smartfriendz/smartrap/README.md

smartrap
========

the easy to build reprap
