smartfriendz/smartrap/doc/smartrap 0.4.9.2-contenu boite.pdf

barres inox | 4x6 + 2x8 - 300mm | barres inox | 4x6 + 2x8 - 300mm
m5 Z | 1x - 220mm | m5 Z | 1x - 220mm

hotend

nozzle 0.4 + barrel 26mm
+ ptfe 15x40 + pressfit+
block alu + thermistor +
| 40w cartridge | hotend | nozzle 0.4 + barrel 26mm
| | | + ptfe 15x40 + pressfit+
| | | block alu + thermistor +
| | | 40w cartridge
mk7 | 1x | mk7 | 1x
printed parts | | printed parts
motors | 4x | motors | 4x
endstops | 3x | endstops | 3x
bearings | 4x lm8uu + 8x lm6uu | bearings | 4x lm8uu + 8x lm6uu
bowden | 1x 70cm | bowden | 1x 70cm
ramps | 1 arduino + 1 ramps 1.4 +
| 4 pololus | ramps | 1 arduino + 1 ramps 1.4 +
| | | 4 pololus
gt2 | 2x 50cm belt + 2x 20
| teeth alu | gt2 | 2x 50cm belt + 2x 20 teeth
| | | alu
2pins 70cm | 2x | 2pins 70cm | 2x
power supply | 1x 6amps 12v | power supply | 1x 6amps 12v
wood | 220x220 10mm multi | wood | 220x220 10mm multi
glass | 220x220 3mm | glass | 220x220 3mm

screws

20x m3x10 , 7x m3x16 ,
3x m3x25 , 3xm3x30 , 1x
| m3x10extrud, 5x m3 nuts, | screws | 20x m3x10 , 7x m3x16 ,
| | | 3x m3x25 , 3xm3x30 , 1x
| | | m3x10extrud, 5x m3 nuts,
zcoupler metal | 1x coupler 5mm/5mm | zcoupler metal | 1x coupler 5mm/5mm
usb cable | | usb cable
power cable | | power cable
fan head | | fan head
filament | | filament
