smartfriendz/smartrap/doc/Screen Shot 2015-01-23 at 09.19.43.png

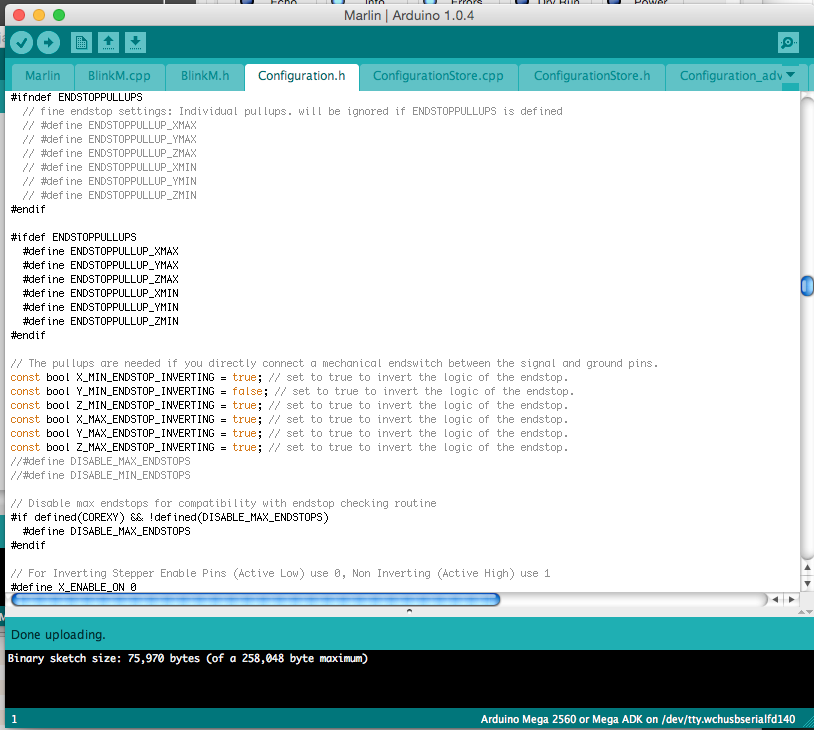
doc/Screen Shot 2015-01-23 at 09.19.43.png
