smartfriendz/smartrap/doc/Screen Shot 2015-01-23 at 09.33.37.png

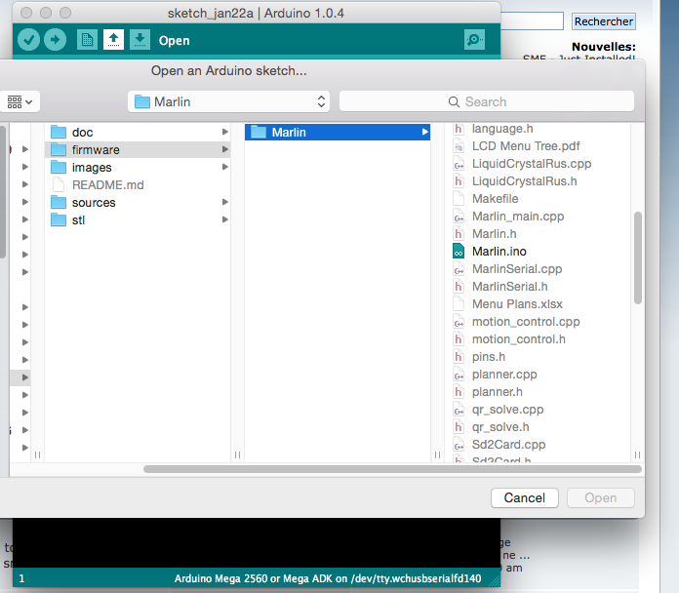
doc/Screen Shot 2015-01-23 at 09.33.37.png
