smartfriendz/smartrap/doc/Screen Shot 2015-01-23 at 09.33.49.png

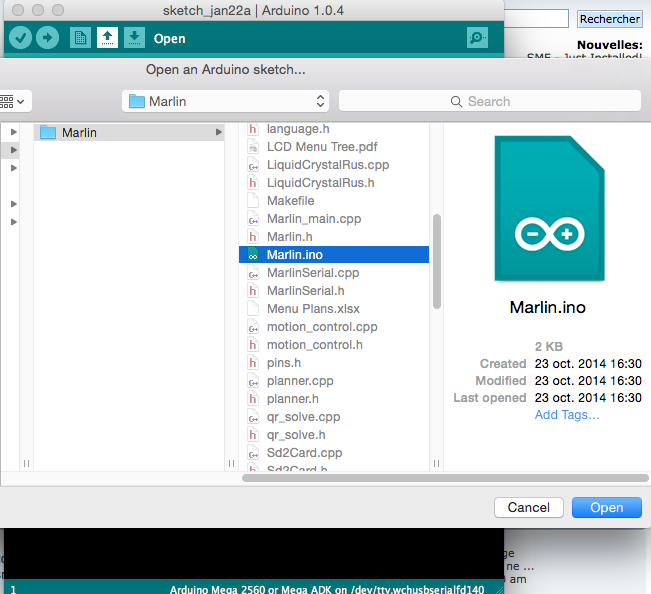
doc/Screen Shot 2015-01-23 at 09.33.49.png
