smartfriendz/smartrap/doc/Screen Shot 2015-01-23 at 09.36.03.png

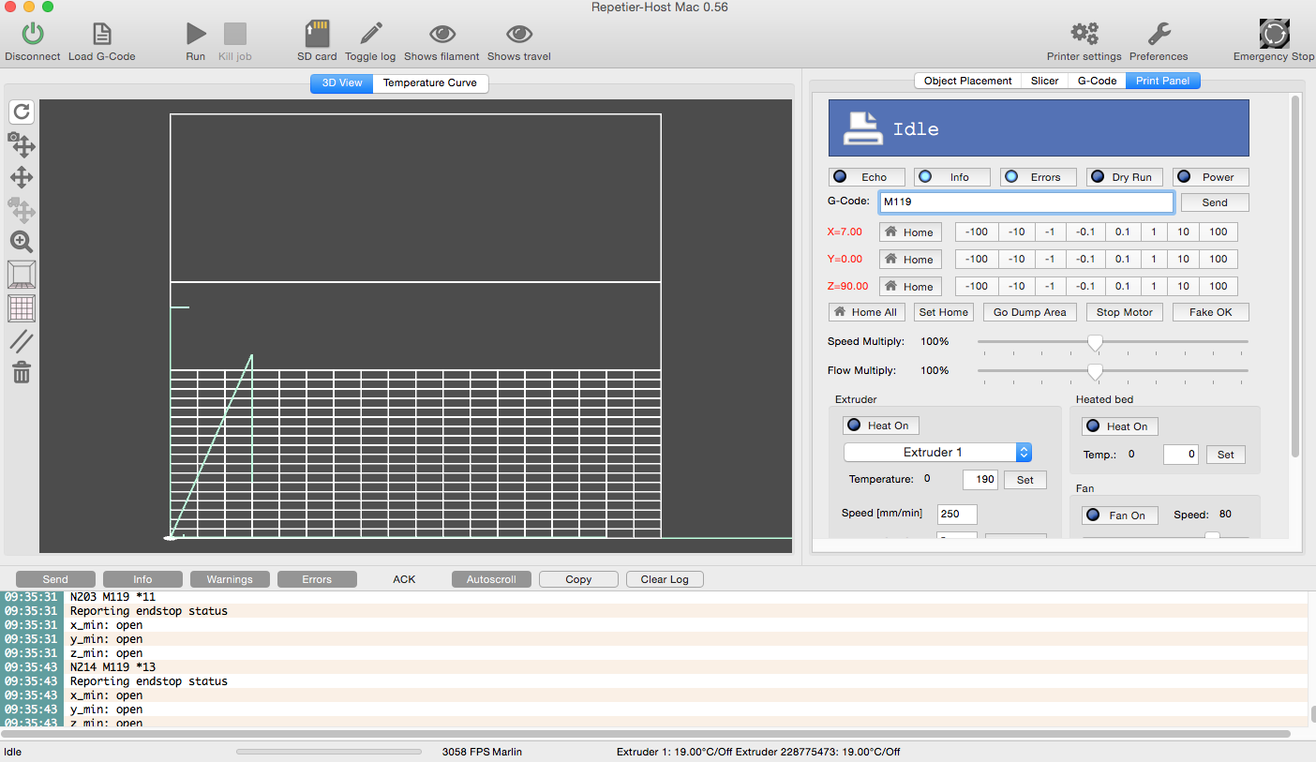
doc/Screen Shot 2015-01-23 at 09.36.03.png
