smartfriendz/smartrap/blender/smartrap_8mm_plateX.stl

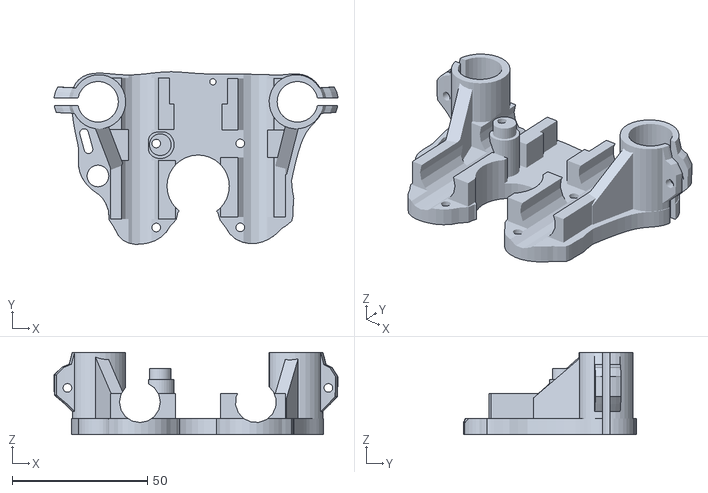
[picture p5: CAD file, 2014-12-14]
blender/smartrap_8mm_plateX.stl
104.9 x 63.7 x 30.4
