smartfriendz/smartrap/stl/separate_Items/endx_jhead_attach.stl

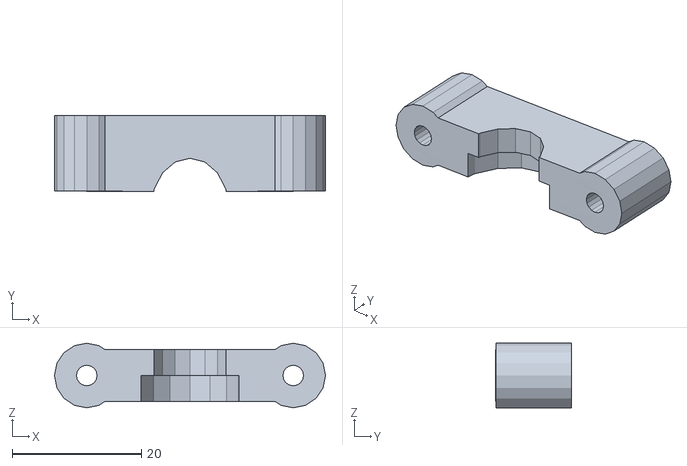
[picture p6: CAD file, 2015-07-18]
stl/separate_Items/endx_jhead_attach.stl
42.0 x 11.7 x 10.0
