smartfriendz/smartrap/stl/smartrap_plates_1on2_jhead.stl

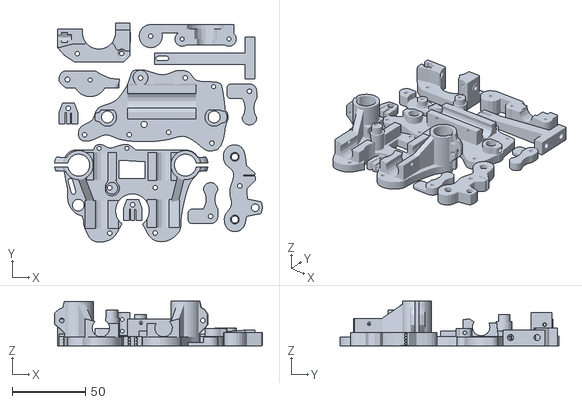
[picture p7: CAD file, 2015-07-18]
stl/smartrap_plates_1on2_jhead.stl
142.1 x 149.8 x 30.4
