smartfriendz/smartrap/stl/separate_Items/endx_jhead_arm.stl

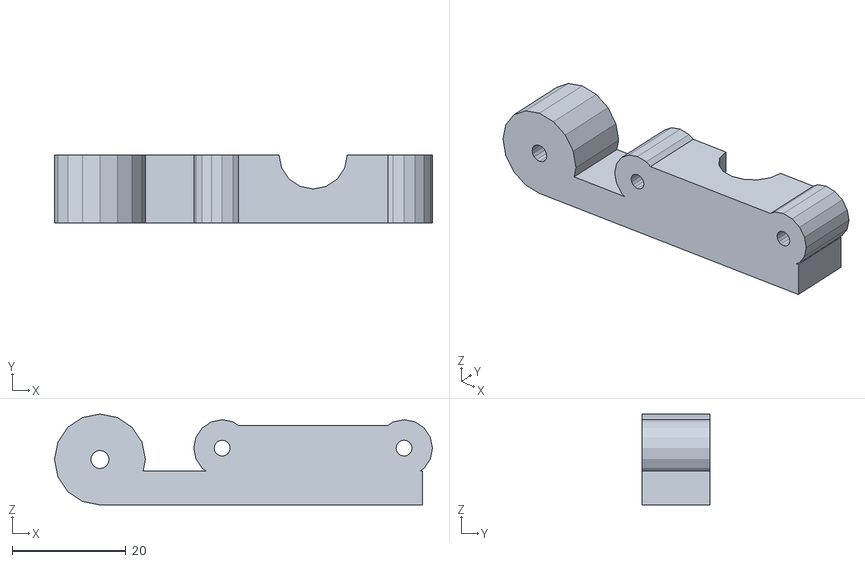
[picture p8: CAD file, 2015-07-18]
stl/separate_Items/endx_jhead_arm.stl
66.5 x 12.0 x 16.0
