smartfriendz/smartrap/stl/smartrap_plates_8mm_gt2_1.stl

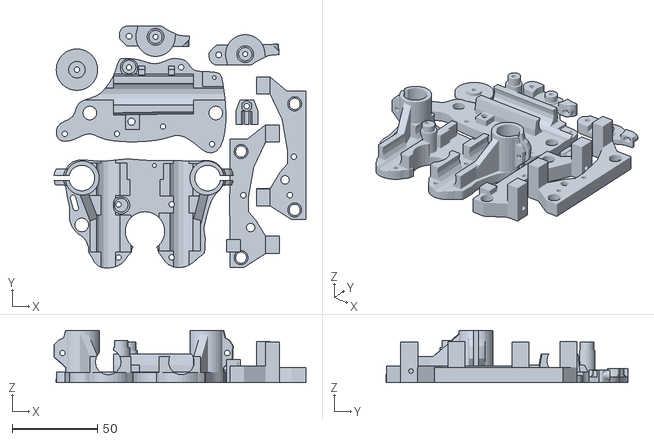
[picture p9: CAD file, 2015-07-18]
stl/smartrap_plates_8mm_gt2_1.stl
147.4 x 141.6 x 30.4
