smartfriendz/smartrap/stl/separate_Items/endx_jhead.stl

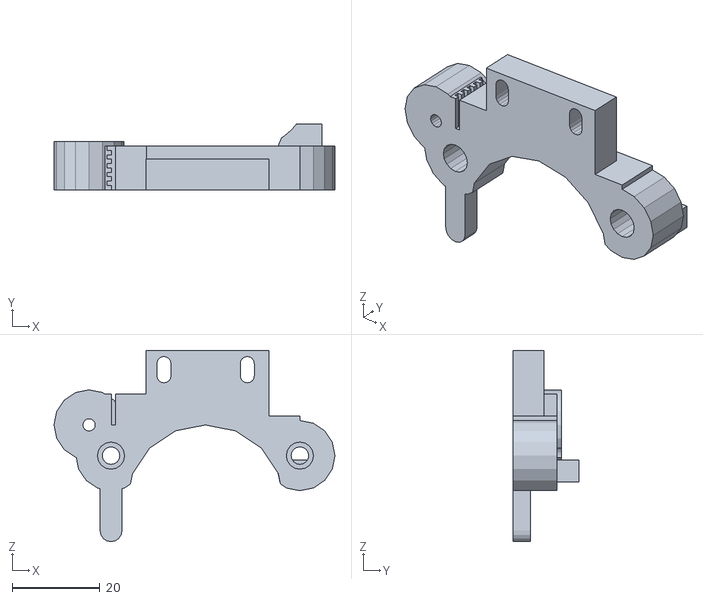
[picture p10: CAD file, 2015-07-18]
stl/separate_Items/endx_jhead.stl
64.1 x 15.0 x 43.6
