smartfriendz/smartrap/stl/smartrap_plates_2on2_jhead.stl

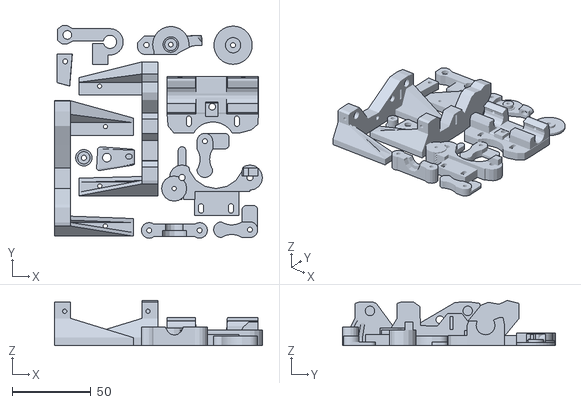
[picture p11: CAD file, 2015-07-18]
stl/smartrap_plates_2on2_jhead.stl
132.0 x 134.9 x 28.6
