smartfriendz/smartrap/stl/separate_Items/endx_jhead_inductive.stl

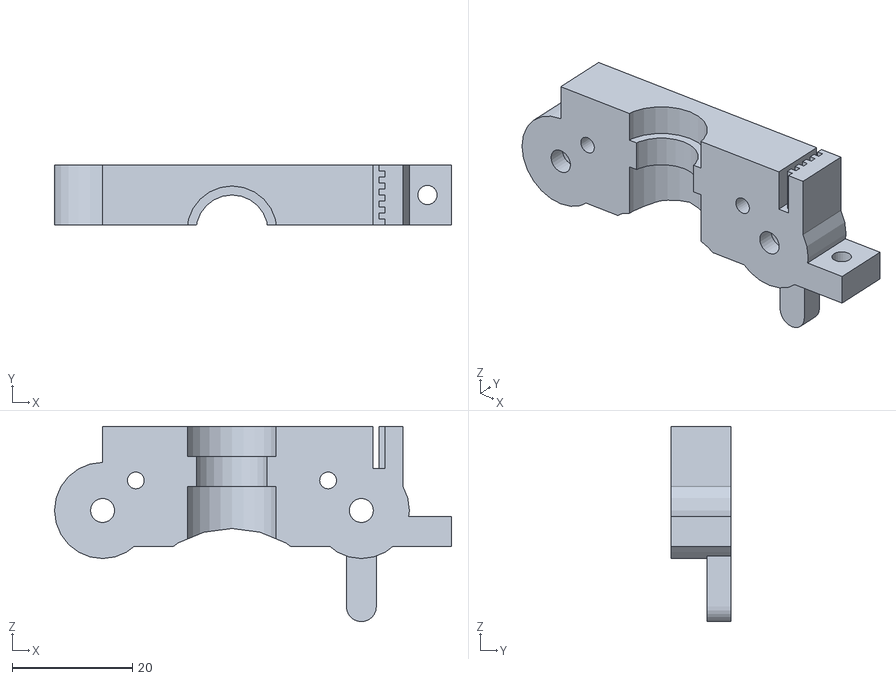
[picture p12: CAD file, 2015-02-06]
stl/separate_Items/endx_jhead_inductive.stl
66.1 x 10.0 x 32.5
