smartfriendz/smartrap/stl/smartrap_plates_8mm_gt2_2.stl

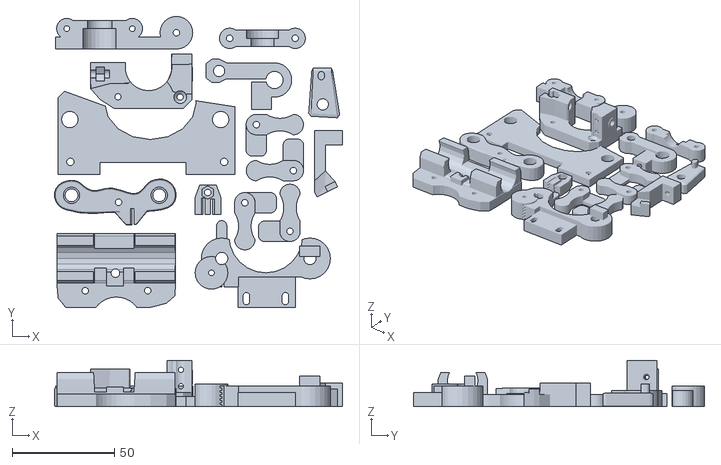
[picture p13: CAD file, 2015-07-18]
stl/smartrap_plates_8mm_gt2_2.stl
140.6 x 142.2 x 22.6
