smartfriendz/smartrap/stl/separate_Items/endx_jhead_inductive_support.stl

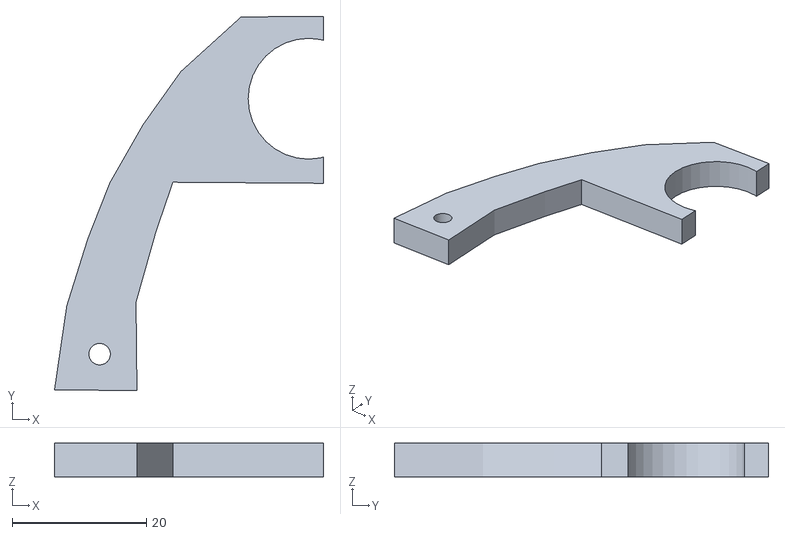
[picture p14: CAD file, 2015-02-06]
stl/separate_Items/endx_jhead_inductive_support.stl
40.1 x 55.8 x 5.02
