smartfriendz/smartrap/stl/separate_Items/endx_jheadlite_inductivesensor_attach.stl

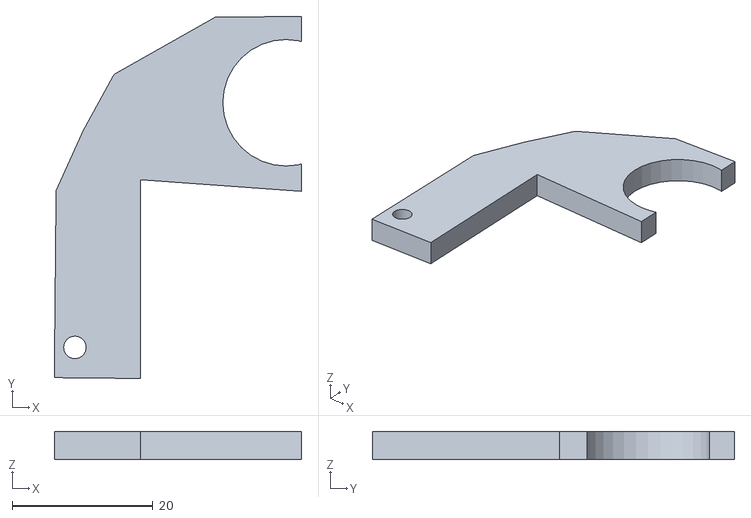
[picture p15: CAD file, 2015-02-06]
stl/separate_Items/endx_jheadlite_inductivesensor_attach.stl
35.2 x 51.5 x 4.00
