smartfriendz/smartrap/stl/separate_Items/directdrive_body_m4.stl

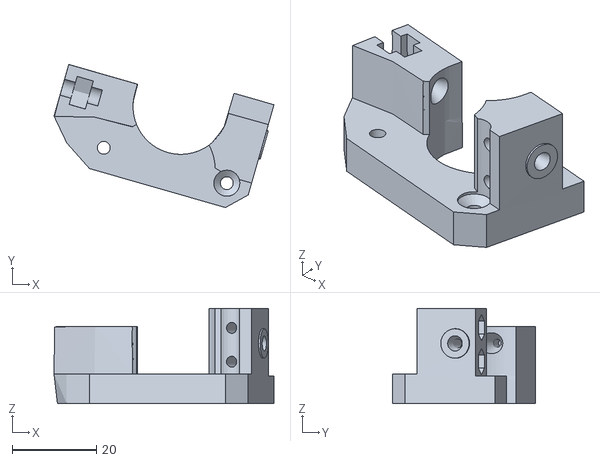
[picture p16: CAD file, 2014-12-14]
stl/separate_Items/directdrive_body_m4.stl
52.2 x 34.0 x 22.6
