smartfriendz/smartrap/stl/separate_Items/directdrive_iddle_10mm_top.stl

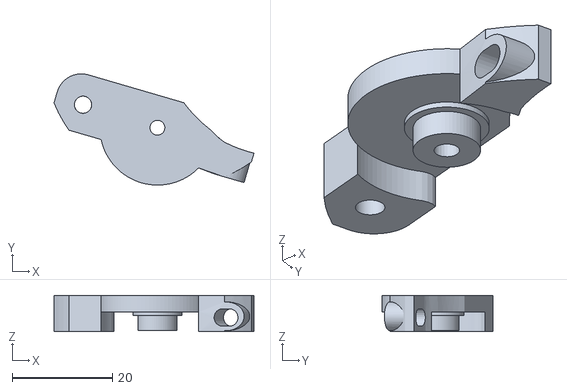
[picture p17: CAD file, 2014-12-14]
stl/separate_Items/directdrive_iddle_10mm_top.stl
39.8 x 22.1 x 7.21
