smartfriendz/smartrap/stl/separate_Items/directdrive_iddle_10mm_bottom.stl

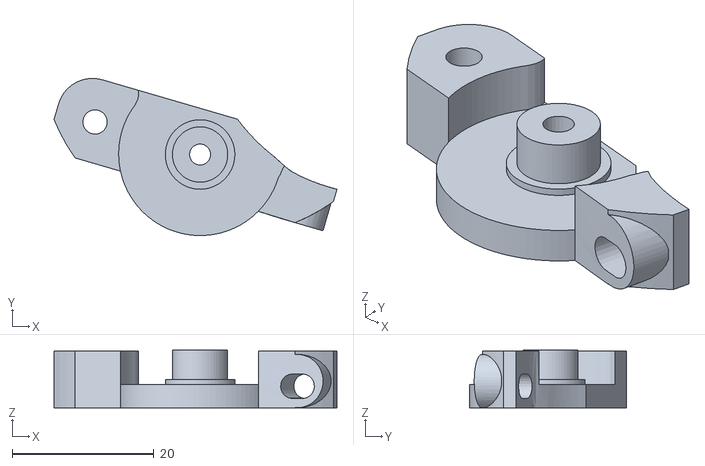
[picture p18: CAD file, 2014-12-14]
stl/separate_Items/directdrive_iddle_10mm_bottom.stl
39.9 x 22.1 x 8.16
