smartfriendz/smartrap/stl/separate_Items/endx_jheadlite_attach.stl

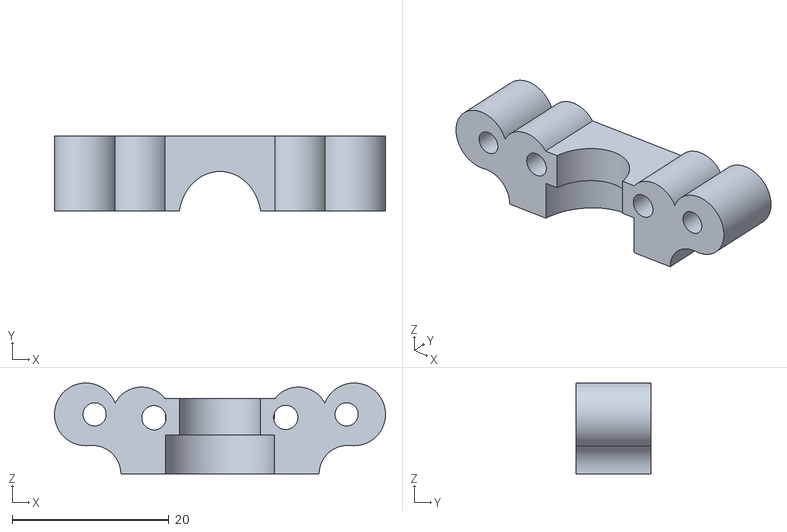
[picture p19: CAD file, 2014-12-14]
stl/separate_Items/endx_jheadlite_attach.stl
42.2 x 9.50 x 11.6
