smartfriendz/smartrap/stl/separate_Items/bottom.stl

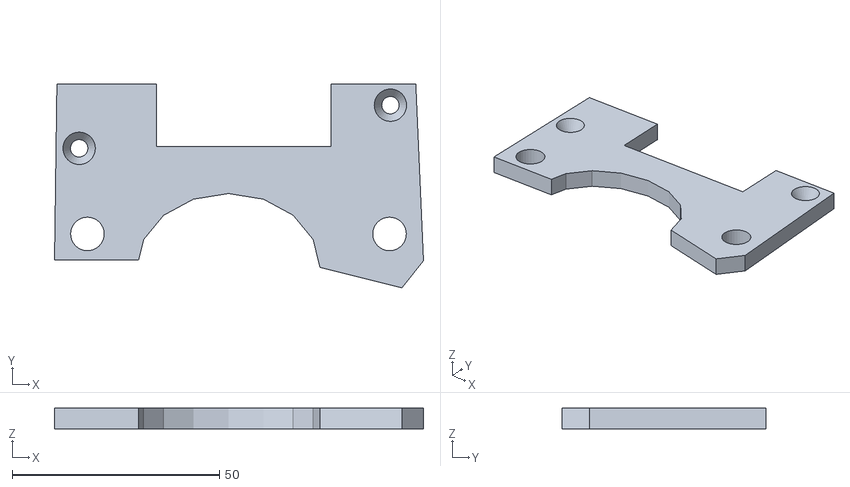
[picture p20: CAD file, 2014-12-02]
stl/separate_Items/bottom.stl
89.0 x 49.1 x 5.00
