smartfriendz/smartrap/stl/separate_Items/directdrive_iddle_7mm_bottom.stl

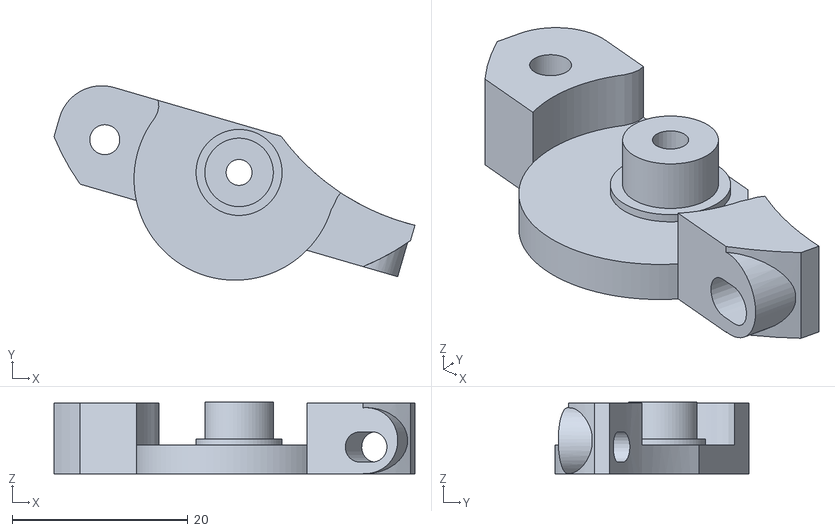
[picture p21: CAD file, 2014-12-02]
stl/separate_Items/directdrive_iddle_7mm_bottom.stl
41.1 x 22.1 x 8.16
