smartfriendz/smartrap/stl/separate_Items/directdrive_iddle_7mm_top.stl

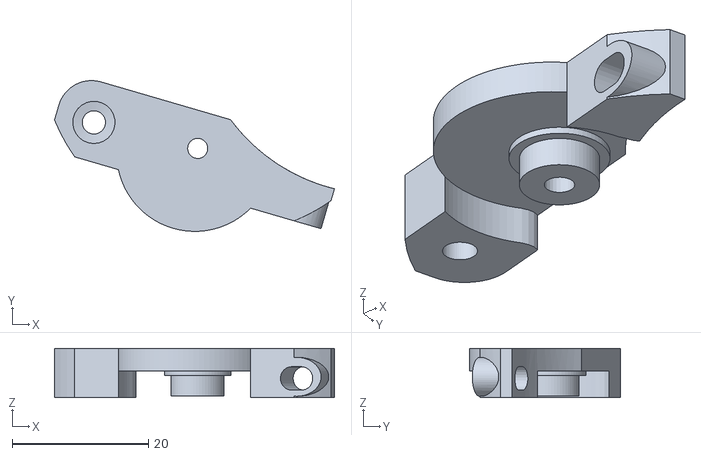
[picture p22: CAD file, 2014-12-02]
stl/separate_Items/directdrive_iddle_7mm_top.stl
41.1 x 22.1 x 7.21
