smartfriendz/smartrap/stl/separate_Items/endx_smartfriendz.stl

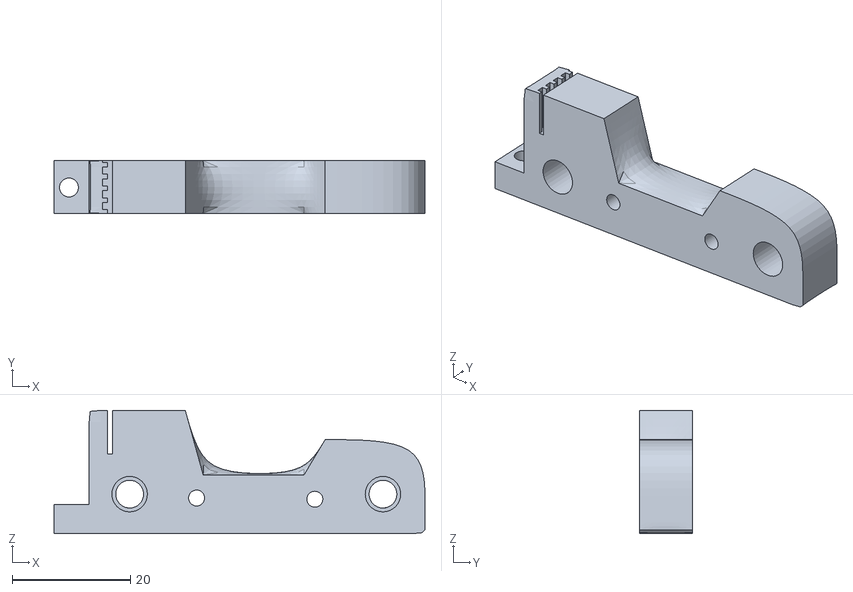
[picture p23: CAD file, 2014-12-02]
stl/separate_Items/endx_smartfriendz.stl
62.7 x 8.91 x 20.8
