smartfriendz/smartrap/stl/separate_Items/endy_front.stl

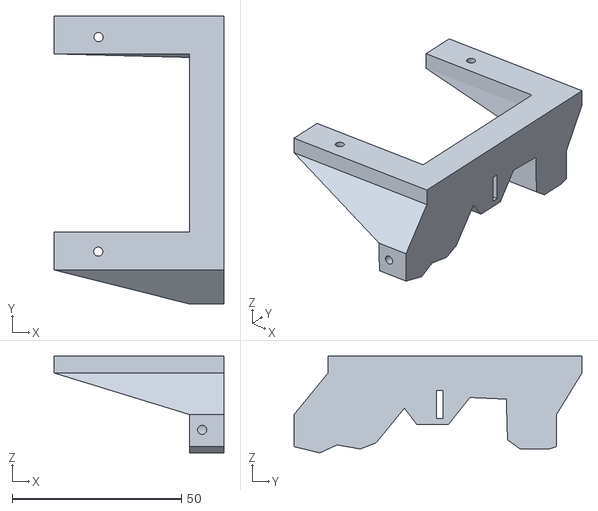
[picture p24: CAD file, 2014-12-02]
stl/separate_Items/endy_front.stl
50.1 x 85.0 x 28.6
