smartfriendz/smartrap/stl/separate_Items/plate_base.stl

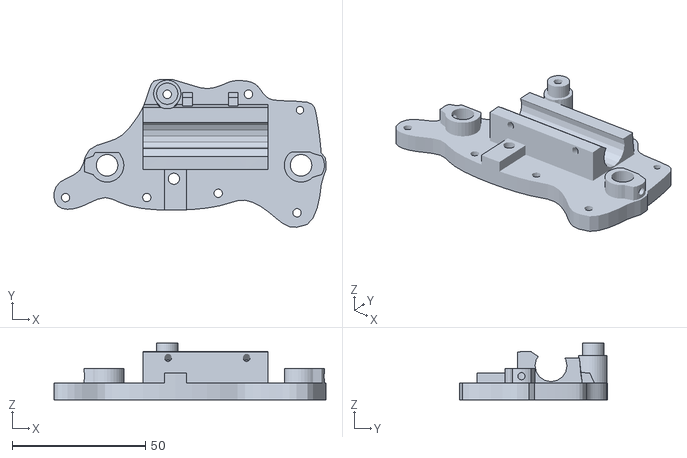
[picture p25: CAD file, 2014-12-02]
stl/separate_Items/plate_base.stl
102.2 x 55.5 x 21.3
