smartfriendz/smartrap/stl/separate_Items/supportBed_40mm.stl

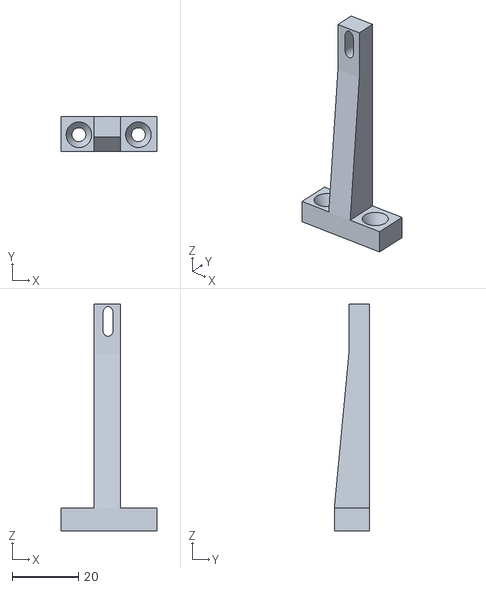
[picture p26: CAD file, 2014-12-02]
stl/separate_Items/supportBed_40mm.stl
29.0 x 10.7 x 68.7
