smartfriendz/smartrap/stl/separate_Items/plateX.stl

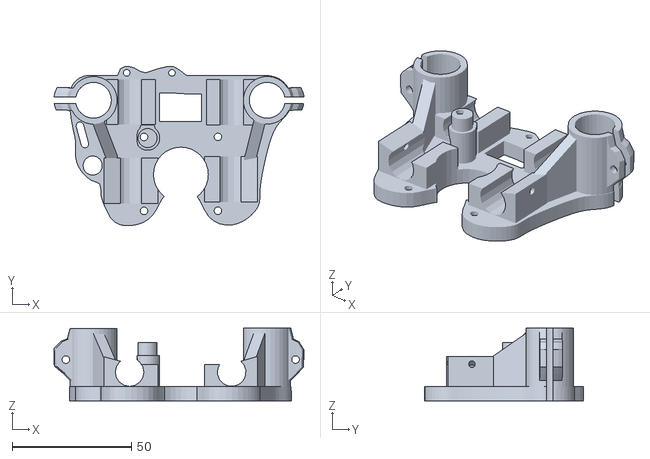
[picture p27: CAD file, 2014-12-02]
stl/separate_Items/plateX.stl
104.9 x 66.9 x 30.4
