smartfriendz/smartrap/stl/separate_Items/directdrive_extra_support.stl

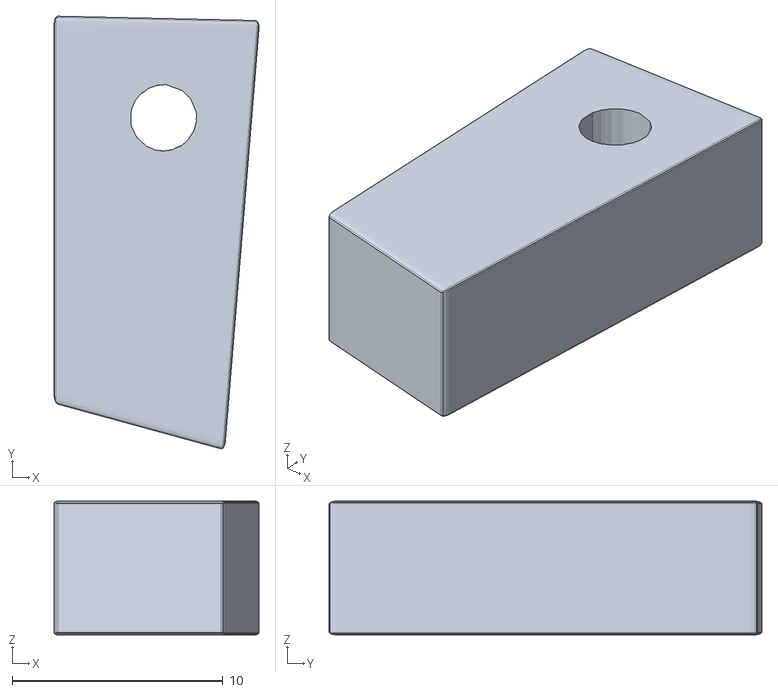
[picture p28: CAD file, 2014-10-28]
stl/separate_Items/directdrive_extra_support.stl
9.72 x 20.5 x 6.35
