smartfriendz/smartrap/stl/separate_Items/antiwobble_top.stl

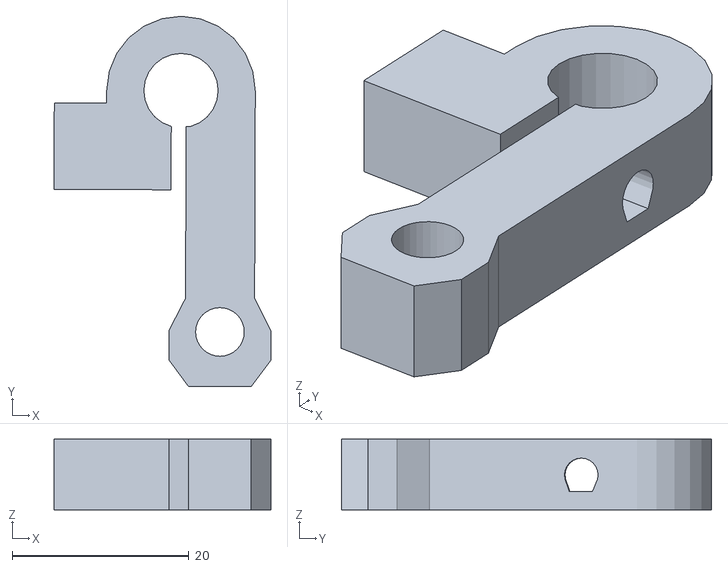
[picture p29: CAD file, 2014-10-28]
stl/separate_Items/antiwobble_top.stl
24.5 x 41.9 x 8.00
