smartfriendz/smartrap/stl/separate_Items/plateY.stl

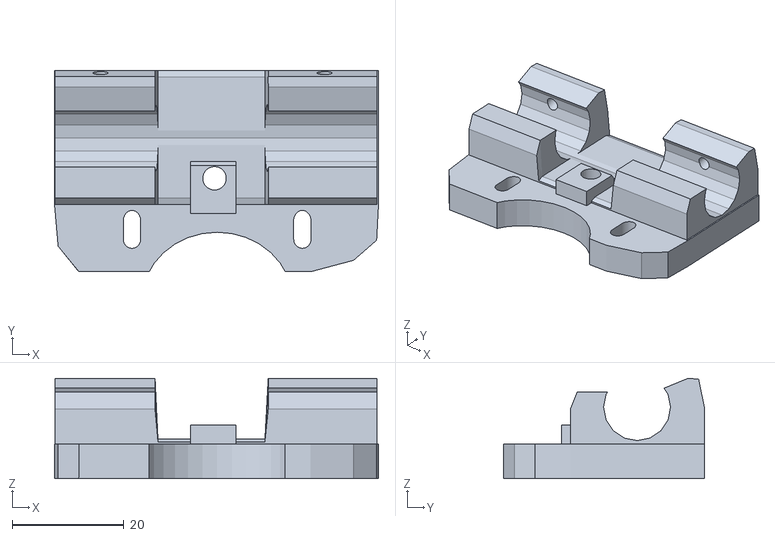
[picture p30: CAD file, 2014-10-28]
stl/separate_Items/plateY.stl
58.0 x 36.1 x 17.9
