smartfriendz/smartrap/stl/separate_Items/antiwobble_support.stl

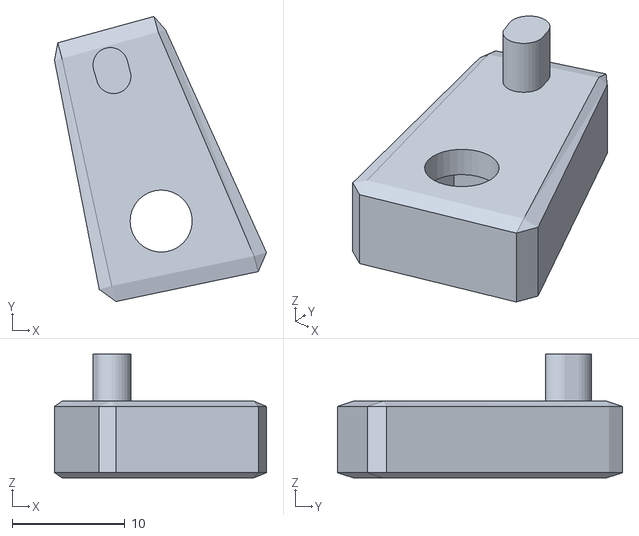
[picture p31: CAD file, 2014-10-23]
stl/separate_Items/antiwobble_support.stl
18.8 x 25.3 x 11.0
