smartfriendz/smartrap/stl/separate_Items/endy_back.stl

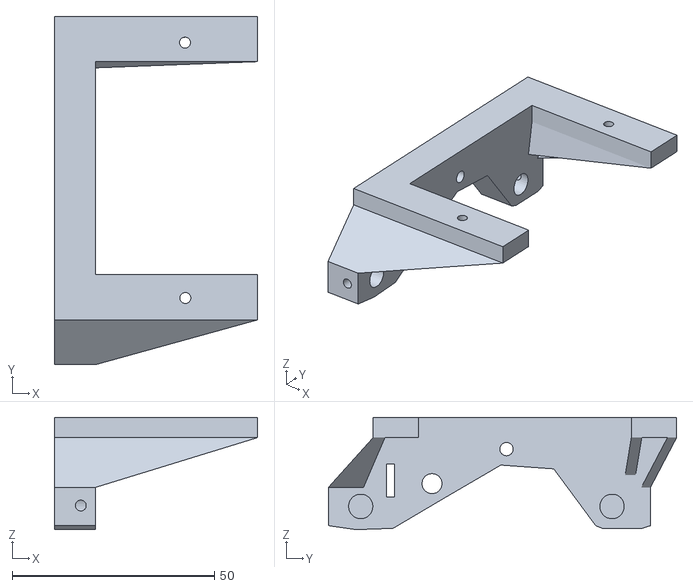
[picture p32: CAD file, 2014-10-23]
stl/separate_Items/endy_back.stl
50.1 x 86.0 x 27.7
