smartfriendz/smartrap/stl/separate_Items/endx_back.stl

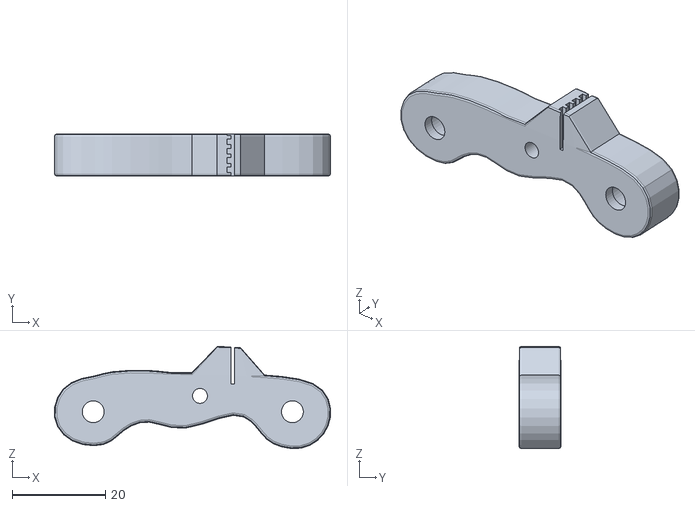
[picture p33: CAD file, 2014-10-23]
stl/separate_Items/endx_back.stl
59.3 x 9.09 x 21.9
