smartfriendz/smartrap/stl/separate_Items/endx_huxley_arm.stl

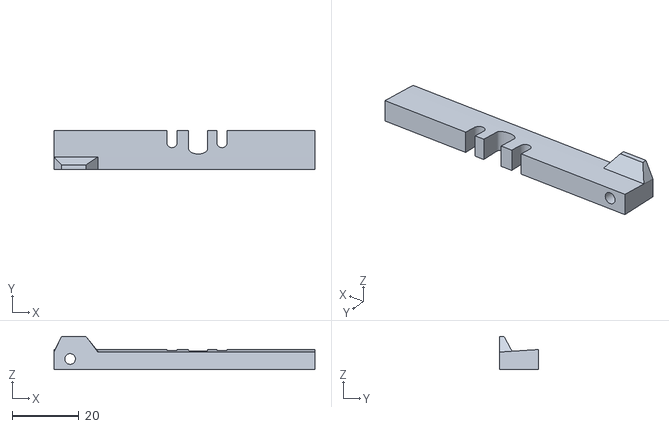
[picture p34: CAD file, 2014-10-23]
stl/separate_Items/endx_huxley_arm.stl
78.2 x 11.7 x 9.97
