smartfriendz/smartrap/stl/separate_Items/endx_jheadlite_inductivesensor.stl

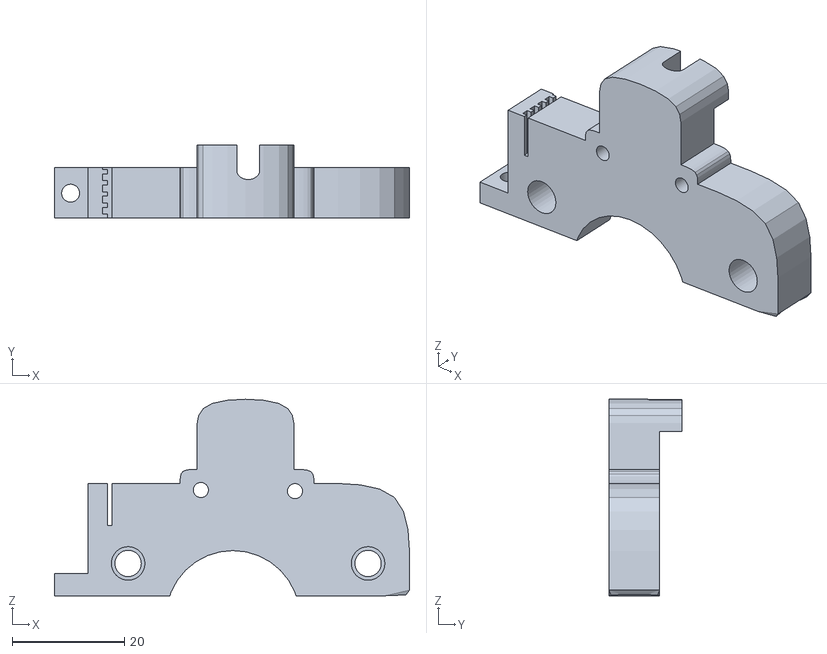
[picture p35: CAD file, 2014-10-23]
stl/separate_Items/endx_jheadlite_inductivesensor.stl
63.4 x 13.0 x 35.1
