smartfriendz/smartrap/stl/separate_Items/endx_jheadlite_switch_arm.stl

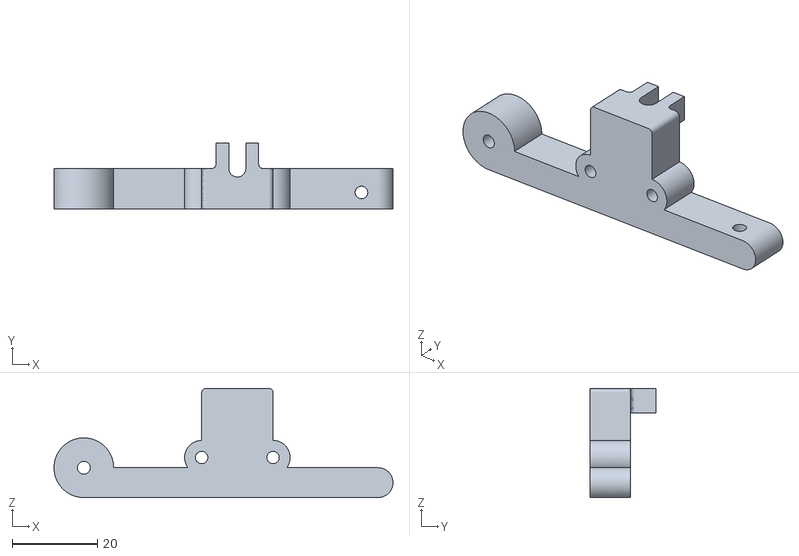
[picture p36: CAD file, 2014-10-23]
stl/separate_Items/endx_jheadlite_switch_arm.stl
79.5 x 15.5 x 25.6
