smartfriendz/smartrap/stl/separate_Items/endx_jheadlite_switch.stl

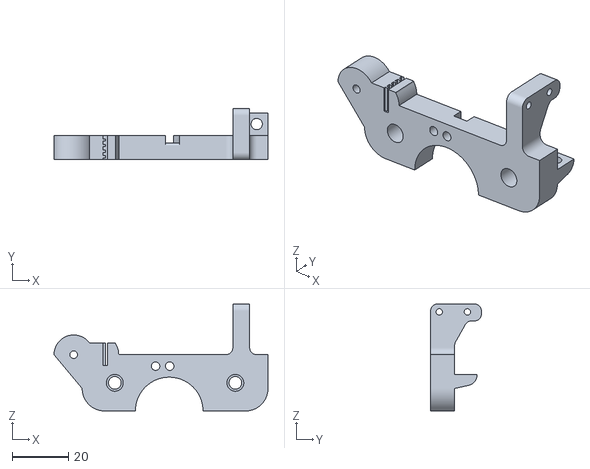
[picture p37: CAD file, 2014-10-23]
stl/separate_Items/endx_jheadlite_switch.stl
76.0 x 18.1 x 38.0
