smartfriendz/smartrap/stl/separate_Items/bearingGT2_support.stl

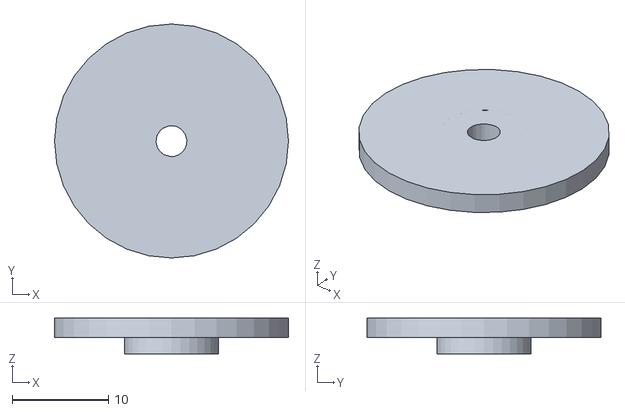
[picture p38: CAD file, 2014-10-23]
stl/separate_Items/bearingGT2_support.stl
24.3 x 24.3 x 3.72
