smartfriendz/smartrap/stl/separate_Items/endx_sensor_support.stl

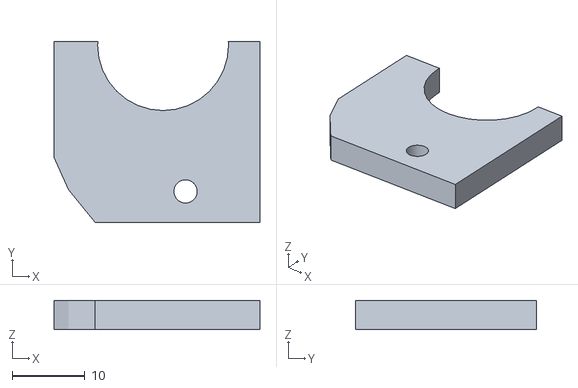
[picture p39: CAD file, 2014-10-23]
stl/separate_Items/endx_sensor_support.stl
28.3 x 24.9 x 4.00
