smartfriendz/smartrap/stl/separate_Items/gt2_attach.stl

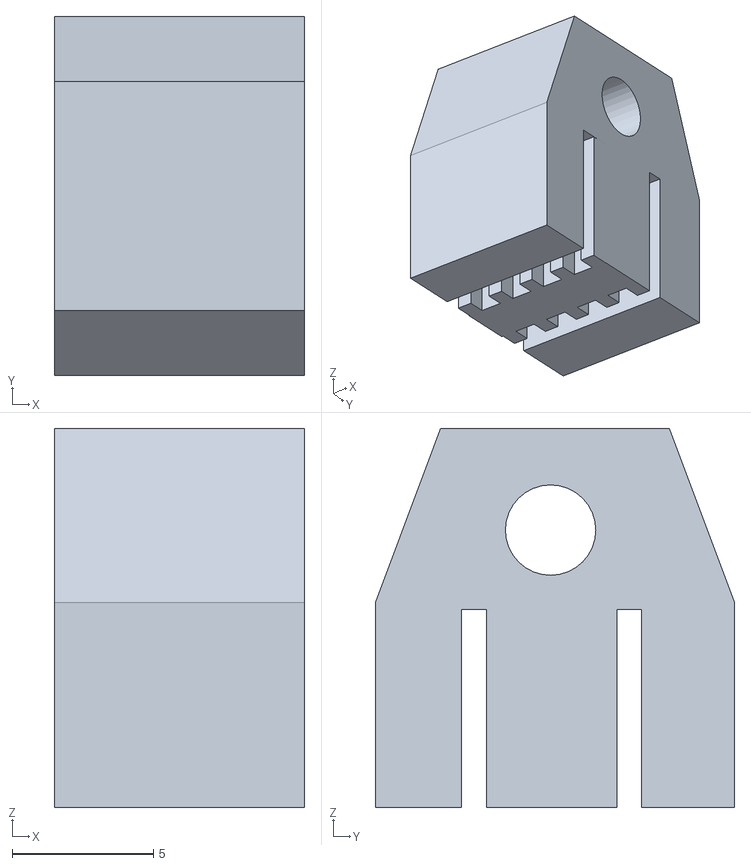
[picture p40: CAD file, 2014-10-23]
stl/separate_Items/gt2_attach.stl
8.87 x 12.7 x 13.4
