smartfriendz/smartrap/stl/separate_Items/bowdenguide.stl

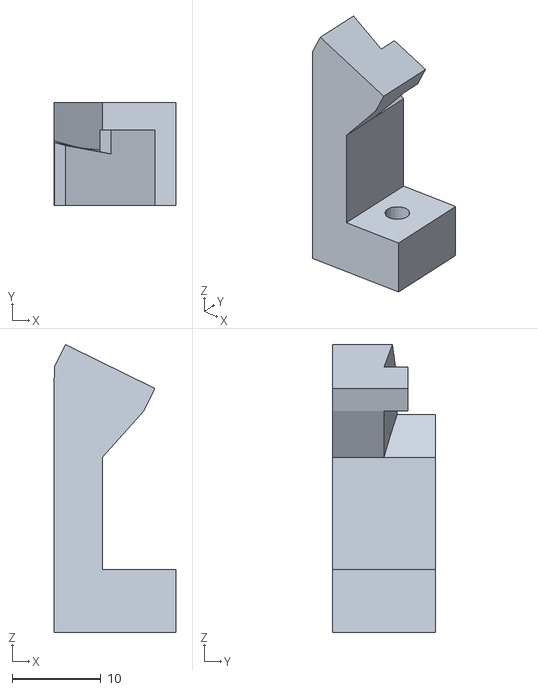
[picture p41: CAD file, 2014-10-23]
stl/separate_Items/bowdenguide.stl
13.7 x 11.7 x 32.5
