smartfriendz/smartrap/stl/separate_Items/glass_support_right.stl

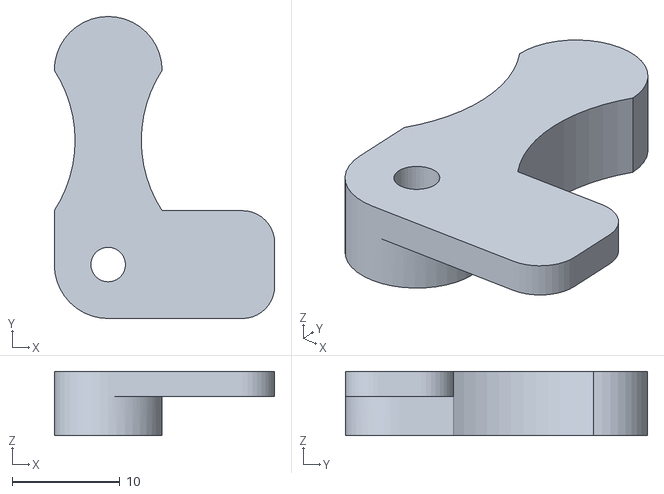
[picture p42: CAD file, 2014-10-23]
stl/separate_Items/glass_support_right.stl
20.4 x 28.0 x 5.97
