smartfriendz/smartrap/stl/separate_Items/endx_huxley_switch.stl

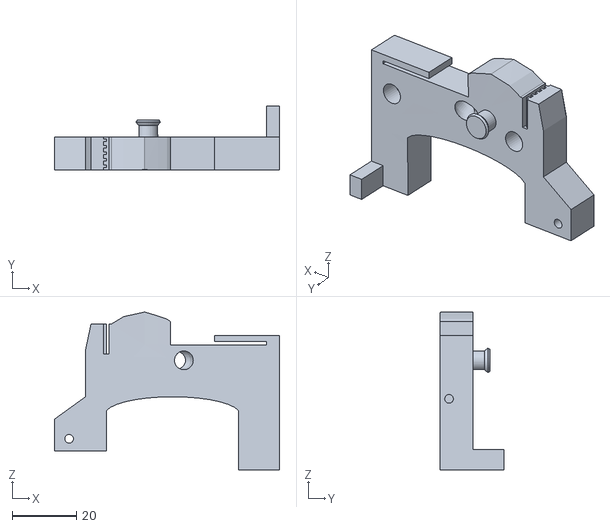
[picture p43: CAD file, 2014-10-23]
stl/separate_Items/endx_huxley_switch.stl
70.0 x 19.9 x 49.1
