smartfriendz/smartrap/(list of files, cad)

Other CAD files:
stl/separate_Items/glass_support_left.stl
blender/dev/assembly0.4.7.blend
blender/dev/assembly0.4.9.blend
blender/dev/smartrap0.4.7_plates.blend
blender/release/smartrap0.4.9_plates.blend
blender/smartrap_8mm_plates.blend
