smartfriendz/smartrap/(commit log)

2013-11-11 initial commit
    start with v0.3. this is the version where all went online.
    [Configuration.h, Configuration_adv.h, Menu Plans.xlsx, jhead_attach.stl, plate_base.stl, plate_x_bottom.stl, plate_x_top.stl, plate_y.stl]
2013-11-11 Revert "initial commit"
    This reverts commit 4a2b35b0e684c3dc36d83447342b5bbb5ed7c155.
    [Configuration.h, Configuration_adv.h, Menu Plans.xlsx, jhead_attach.stl, plate_base.stl, plate_x_bottom.stl, plate_x_top.stl, plate_y.stl]
2013-11-11 initialize.
    Starting with v0.3 online.
    [jhead_attach.stl, plate_base.stl, plate_x_bottom.stl, plate_x_top.stl, plate_y.stl, shaft_coupling_5mm.stl, x_end.stl, x_end_jhead.stl]
2013-11-12 lm8 holders
    lm8 holders was too small. stl files
    [plate_base.stl, plate_x_bottom.stl, plate_x_top.stl, plate_y.stl]
2013-11-13 adjust 0.3 and new 0.4
    [plate_X.stl, plate_Y.stl, plate_base.stl, plate_y.stl]
2013-11-14 update 04.
    plates back to 6mm.
    [plate_X.stl, plate_Y.stl, plate_base.stl]
2013-11-14 changed x_end jhead
    [plate_X.stl, plate_base.stl, x_end.stl, x_end_jhead.stl, x_end_jhead_attach.stl]
2013-11-14 cleaning files
    [Y_end_back.stl, Y_end_front.stl]
2013-11-15 extruder change
    the bearing was too far.
    some new pics.
    [plate_base.stl]
2013-11-17 bug : plate_Y, plate_X
    plate_Y : lm8 holders was wrong, too low, too small
    plate_X: M5 holder was too low under the plate
    [plate_X.stl, plate_Y.stl]
2013-11-18 update 3 plates: lm8 holders
    made them larger. now hole is 15.6
    [plate_X.stl, plate_Y.stl, plate_base.stl]
2013-11-18 jhead_xend missing hole
    one boolean was not here
    [x_end_jhead.stl]
2013-11-21 move up X Y rods
    + enlarge lm8 holders to 24.5
    + first version 0.5 (not finished).
    + realign rods on X
    [Y_end_back.stl, Y_end_front.stl, plate_X.stl, plate_Y.stl, plate_base.stl, x_end.stl, x_end_jhead.stl]
2013-11-22 add version 0.4.5
    no more wood. smaller plates. testing now
    [plate_X.stl, plate_Y.stl, plate_base.stl]
2013-11-25 ceaning version stl files.
    now we have separate version in folders.
    [jhead_attach.stl, plate_X.stl, plate_Y.stl, plate_base.stl, plate_x_bottom.stl, plate_x_top.stl, plate_y.stl, rack_herringbone.scad]
2013-11-26 update 0.4.5 + first 0.5
    update 04.5 for the new romving wood base.
    first V0.5 : lot of changes . most notable being the rack&pinion
    [plate_X.stl, plate_Y.stl, plate_base.stl, rack.stl, rack_herringboneWallace.scad]
2013-11-27 update v0.4 v0.5
    04: lower guides holders again. better shape. add renforcement for z
    axis. test no more wood base.
    05: changed z / x axis position!! back to holders
    [lm8attach.stl, pinion_small.stl, plate_Y.stl, plate_base.stl, plate_x.stl, rack_100mm.stl]
2013-11-28 V 0.4 cleaning + updates
    cleanup mesh
    new fishline tensioner
    new X_end_jhead
    [Y_end_back.stl, Y_end_front.stl, fishline_tensionner.stl, plate_X.stl, plate_Y.stl, plate_base.stl, x_end.stl, x_end_jhead.stl]
2013-11-28 more V0,4 debug
    missed two holes in xend jhead
    reshaped y end back to be better for print
    [Y_end_back.stl, x_end.stl, x_end_jhead.stl]
2013-11-28 version 045
    copy from 04: change lm8holders to separate parts (too much break).
    reduce size of base and X
    new fishingline holders
    zrod holders. test without wood base.
    [fishingline_holder.stl, jhead_attach.stl, lm8_holder_base.stl, lm8_holder_x.stl, plate_base.stl, plate_x.stl, plate_y.stl, x_end.stl]
2013-11-29 V0.4.5 updates
    adjust lm8 holders.
    plateX : update shape .was pb with holders Z
    [lm8_holder_base.stl, lm8_holder_x.stl, lm8_holder_y.stl, plate_x.stl]
2013-11-29 update 0.4.5
    more update with lm8holders. was too short.
    [lm8_holder_base.stl, lm8_holder_x.stl, lm8_holder_y.stl]
2013-11-30 v0.4.5: lm8holders
    new update lm8holders base.
    [fishingline_holder.stl, lm8_holder_base.stl, lm8_holder_base_2.stl, lm8_holder_x.stl, lm8_holder_y.stl]
2013-12-03 0.4.6: update lm8 holders
    made larger the bottom, so we ca use a m3x16. and more solid base to
    fix together plate_base and plate_Y
    [lm8_holder_base.stl, lm8_holder_base_2.stl, lm8_holder_x.stl, plate_base.stl]
2013-12-03 0.4.5: more updates
    new snapping z bolt on plate_x
    [plate_x.stl]
2013-12-05 testing 4.6
    new bottom.to get rid of the wood
    new end y : fixed system. will use z auto prob with manual switch
    changed plate base / plate y to recenter the motor
    [bottom_center.stl, bottom_y.stl, bottom_z_extruder.stl, end_y_back.stl, end_y_front.stl, plate_base.stl, plate_x.stl, plate_y.stl]
2013-12-05 0.4.6 update
    more adjustments with new end_Y
    [bottom_y.stl, end_y_back.stl, end_y_front.stl]
2013-12-07 0.4.6 updates
    first integration auto levelling.
    changes end y
    [end_y_back.stl, end_y_front.stl]
2013-12-08 0.4.5: bug plate_x
    was one of bearing holers too tight.
    [plate_x.stl]
2013-12-09 0.4.5 changed some sizes 0.4.6:contuation
    0.4.5: my printer was wrong. i went back to more normal sizes for rods
    holes . Adjusting also extruder positions. i’m affraid it was too far :(
    0.4.6: continuation of adjustments after tests. soon ok to print.
    very first not usuable smartrap.scad :)
    [Smartrap.scad, plate_base.stl, plate_x.stl]
2013-12-09 same as precedent. was little miss
    [plate_base.stl, x_end.stl]
2013-12-09 cleaning stl 0.4.5
    was some confusion with stl from 0.4.6 in 0.4.5 folder.
    [Smartrap.scad, lm8_holder_base_2.stl, plate_x.stl, x_end_jhead.stl, y_end_back.stl, y_end_front.stl]
2013-12-09 0.4.5: bug plate_base bearing size
    was a bug with bearing for the extruder. So it was always too far to
    grip the filament. repaired now.
    update BOM
    update scad
    [Smartrap.scad, lm8_holder_base.stl, lm8_holder_base2.stl, plate_base.stl, plate_x.stl]
2013-12-12 all updates
    0.4.5: trying new plate_Base. was a problem to slice
    0.4.6: updating a little everywhere. not fo prod
    scad : progressing
    [Smartrap.scad, bottom_center.stl, bottom_y.stl, bottom_z_extruder.stl, end_x_jhead.stl, plate_base.stl]
2013-12-19 folders reorganisation
    more standard : release, dev, old.
    [Smartrap.scad, Y_end_back.stl, Y_end_front.stl, bottom_center.stl, bottom_y.stl, bottom_z_extruder.stl, end_x_jhead.stl, end_y_back.stl]
2013-12-21 update versions.
    0.4.6 become release.
    [bottom_center.stl, bottom_y.stl, bottom_z_extruder.stl, end_x_jhead.stl, end_y_back.stl, end_y_front.stl, fishingline_holder.stl, jhead_attach.stl]
2013-12-26 mk7 modif
    mk7
    enlarged lm8 holders to be more tight
    [Smartrap.scad]
2013-12-29 update / corrections 0.4.6
    missed jhead attach stl
    plate_x : snap for m5 zrod was not right.
    [bottom_center.stl, bottom_y.stl, bottom_z_extruder.stl, end_y_back.stl, extruder_bearing_holder.stl, jhead_attach.stl, lm8_holder_base.stl, lm8_holder_base2.stl]
2014-01-02 update release
    holes for ends y and x where too big (8.5). now back to 8mm
    [bottom_center.stl, end_x_back.stl, end_x_jhead.stl, end_y_back.stl, end_y_front.stl, lm8_holder_x.stl]
2014-01-04 update release
    extend plate_x for endstop
    changed plate_x back .optimisation
    changed plate_base extend for endstop Y
    changed end_y_front .extension for endstop Y
    add botoom Y ramps
    [bottom_y_ramps.stl, end_y_front.stl, lm8_holder_x.stl, plate_base.stl, plate_x.stl]
2014-01-12 marlin copy and settings
    this is the marlin used by smartrap.
    [Configuration.h, Configuration_adv.h, Menu Plans.xlsx, Smartrap.scad, lm8_clip_y.stl, printedlm8.blend, printedlm8.stl, test_holes.blend]
2014-01-16 testing 0.5
    new minimum printed as solid as rock.
    [fishingline_holder.stl, plate_x_back.stl, plate_z_top.stl]
2014-01-16 realease updates + dev things..
    [end_x_jhead.stl, plate_x_back.stl, printable-lm8uu.scad]
2014-01-17 cleaning release
    all changed.. a little.
    [bottom_center.stl, bottom_y_ramps.stl, bottom_z_extruder.stl, end_x_huxley.stl, end_y_back.stl, end_y_front.stl, extruder_bearing_holder.stl, lm8_holder_base.stl]
2014-01-17 change name botom_y
    with option monitronics or ramps
    [bottom_y_minitronics.stl, support_minitronics.stl]
2014-01-20 update conf
    [Configuration.h]
2014-01-21 46 updates
    [end_x_huxley.stl]
2014-01-30 update production
    lot of changes in every part for production.
    [Configuration.h, bottom_y_ramps.stl, end_x_huxley.stl, end_y_back.stl, end_y_front.stl, extruder_bearing_holder.stl, lm8_holder_x.stl, lm8_holder_x_back.stl]
2014-02-03 production update
    soon V1 ( first shipped version).
    all models changed..a little.
    add cable holder
    new plate_y separate
    back to old bed holders (new will be in option)
    changed base for more solid
    change end_x_huxley for more space on servo space
    bearing holder x : new holders front on plate_x
    new fishing line tension back separate ( was breaking)
    plate_x changed for more strong supports on the side
    new bearing holders holes : larger : was too tight and printer
    resolution dependent
    new reprappro tongue on extruder for bowden cable ( brass element)
    [Configuration.h, bottom_center.stl, bottom_y_ramps.stl, bottom_z_extruder.stl, end_x_huxley.stl, end_y_back.stl, end_y_front.stl, fishingline_holder_end_y_back.stl]
2014-02-04 production updates
    extruder bearing too far- again!
    back to new y ends
    new system for lm8holder x
    new end y support glass
    [end_y_back.stl, end_y_front.stl, end_y_support_glass.stl, lm8_holder_x.stl]
2014-02-04 production update
    extruder bearing more near
    new holder for bowden under z coupler
    [bowden_bloker.stl, extruder_bearing_holder.stl, plate_base.stl]
2014-02-04 production
    marlin
    [Configuration.h]
2014-02-05 marlin
    was setting for 0.9 but back.
    [Configuration.h]
2014-02-05 production update
    one more screw for bearing extruder. now solid.
    should be the real reduction model
    will be updated on thingiverse.
    [bottom_y_ramps.stl, extruder_bearing_holder.stl, plate_base.stl]
2014-02-06 production
    extruder : was a pb with mk7 and screw with bearing.
    plate_y : too low on exterior
    [bottom_center.stl, plate_base.stl, plate_y.stl]
2014-02-06 marlin
    for prod
    [Configuration.h]
2014-02-06 production
    change back plate y
    back z coupler
    add tongue . reprappro bowden holder
    [end_y_support_glass.stl, end_y_support_glass_x4.stl, fishingline_holder.stl, fishingline_holder_x2.stl, lm8_holder_y_back.stl, lm8_holder_y_front.stl, plate_y.stl, thumbwheelM3.stl]
2014-02-08 production
    changed end y : move further away from center.
    simplify glass attach
    [SpoolHolder.scad, end_y_back.stl, end_y_front.stl]
2014-02-08 prod
    config new delta servo
    [Configuration.h, set_end_y.stl]
2014-02-10 production
    changed end_Y : was not horizontal because of holders pressure. hack
    for now, we adapt the end_Y so the plate is flat after screwing.
    [end_y_back.stl, end_y_front.stl]
2014-02-10 prod
    changed hack marlin.cpp to 0.6
    [Configuration.h, set_bottom_small_parts.stl]
2014-02-10 more production update
    plate_X : m5 nuts less wide. was small backslash
    end_Y : smooth rods holes less far . was too fragile.
    [end_y_back.stl, end_y_front.stl, plate_x.stl]
2014-02-10 prod
    spool holder
    changes endy : back
    [SpoolHolder.stl, end_y_back.stl, end_y_front.stl]
2014-02-11 production
    base: adjusted nuts holes to be more easy to mount
    [bottom_center.stl, plate_base.stl]
2014-02-13 production
    plate_X : changed a little height of lm8 holders blockers
    holders Y : now two times the same. little less tight ( was too much
    and blocked the axis ).
    [lm8_holder_y.stl, plate_base.stl, plate_x.stl]
2014-02-13 production
    more adjustments to levelling
    [Configuration.h, set_endy.stl]
2014-02-16 production
    clean up the release stl files ( where too much )
    [lm8_holder_y_back.stl, lm8_holder_y_front.stl, set_bottom_small_parts.stl, set_end_y.stl, thumbwheelM3.stl, thumbwheel_m3.stl]
2014-02-19 production
    extruder : a little further. now it’s very strong, it was too near.
    base_x_extruder : m4x60 was too short. i’ve put a hole for integrated
    screw.
    y_lm8_holders : a little higher : was too low and with new btw screw it
    was not pressing enough
    [Configuration.h, bottom_z_extruder.stl, extruder_bearing_holder.stl, lm8_holder_y.stl, plate_base.stl]
2014-02-19 production
    small changes and 2 sets for print
    [Configuration.h, set_Y.stl, set_endy.stl, set_small_parts.stl]
2014-02-21 production
    config marlin prod version! with servo behind the head. not for j-head
    [Configuration.h, spool_holder_30mm.stl]
2014-02-25 production
    add var + new lcd version
    [Configuration.h, Configuration_adv.h, Menu Plans.xlsx, set_Y.stl, set_end_y.stl]
2014-02-25 production
    base with higher bearing support
    head connector doc
    [bowden_bloker.stl, plate_base.stl]
2014-03-03 marlin lcd andsmall parts prod
    [Configuration.h, set_small_parts.stl]
2014-03-03 production
    changed bottom z extruder to smaller. no need
    end x huxley : fishing line lower for new thick cline
    [bottom_z_extruder.stl, end_x_huxley.stl]
2014-03-03 sets for plate
    [set_small_parts.stl]
2014-03-03 prod
    will redo the plates. now just small parts
    [bowden_guide.stl, set_Y.stl, set_end_y.stl]
2014-03-05 prod
    was missing extension
    [set_Y.stl, set_bottom.stl]
2014-03-07 prod
    servo_holder adapted to be thinker. switch cacn fall down too easy
    [Configuration.h, servo_holder.stl]
2014-03-07 prod
    stl the right way
    [Configuration.h, bottom_center.stl, bottom_y_ramps.stl, bottom_z_extruder.stl, end_x_back.stl, end_x_huxley.stl, end_y_back.stl, end_y_front.stl]
2014-03-08 prod
    little change in blender. but nothing important.
    configuration.h has more comments: search for word “smartrap” and you
    find any line i’ve worked on with comment/ options..etc
    [Configuration.h]
2014-03-09 production: jhead update, marlin new version, zcouplernew
    blender,stl : updated jhead to current servo config
    updated endxback , fishing line holder for shorter screws
    added test coupler printed no screws.
    marlin : new version with settings and mod ifs for smartrap
    : manage 3 versions ( 2 servo types and 2 nema17 motors types_
    modif smartrap delta zprobe.
    [Configuration.h, Configuration_adv.h, Menu Plans.xlsx, end_x_back.stl, end_x_jhead.stl, fishingline_holder_x2.stl, jhead_attach.stl, z_coupler_cylinder.stl]
2014-03-09 marlin smartrap
    add M555 : set Zprobe offset from extruder command
    [Configuration.h]
2014-03-09 marlin
    update : passed to grid zprobe. looks like there's no more need of our
    hack.. other calculations, better result.
    [Configuration.h]
2014-03-11 new shaft adaptor for robodig motors, updates
    updated slicer config (prod version)
    deleted marlin lcd.. as the main marlin does it with uncomment one line.
    [Configuration.h, Configuration_adv.h, Menu Plans.xlsx, shaft_adaptor.stl]
2014-03-12 marlin firmware
    new easy config (some #define on top of configuration.h) special
    smartrap.
    changed probing sequence: now we raise_between_probes before retract
    servo. In smartrap , servo could block on the glass when we retract on
    the low point. now we get down, probe, go up and retract.
    [Configuration.h]
2014-03-12 marlin
    uncomment the Z_RAISE_BETWEEN_PROBINGS_BEFORE_RETRACT for now.. it has
    side effect. not good.
    [Configuration.h]
2014-03-17 new glass support
    [Configuration.h, end_y_support_glass_left.stl, end_y_support_glass_right.stl, end_y_support_glass_x4.stl]
2014-03-23 production + dev
    marlin : config.h with new easy setup for different configs smartrap (
    motors, servo, lcd..) on top .
    stl : new plate base + servo holder for maritime brass gear updated.
    new holder Y lm8 . separated . x4 . looks like it’s better for
    linearity.
    dev: start of x axis fix (head moving).
    [Configuration.h, extruder_bearing_holder.stl, extruder_bearing_holder_brass.stl, glass_holder.stl, lm8_holder_base.stl, lm8_holder_x.stl, lm8_holder_yx4.stl, plate_base.stl]
2014-03-29 marlin
    production update
    changed Z max federate from 5 to 3
    changed motor 1840 steps xy : 99
    [Configuration.h]
2014-03-29 dev
    some little changes and tests for new version.
    [end_y_front.stl, glass_support.stl, plate_base.stl, rodholder.stl, z_coupler_cylinder.stl]
2014-04-01 dev (soon release)
    new auto level no servo.
    new folder marlin going with it.
    new plate base and palte y with integrated lm8 support. now separated
    from motor attach.
    new support for wood base ( back in game).
    [Configuration.h, end_x_huxley.stl, endx_support_endstopZ.stl, extruder_bearing_holder.stl, huxley_attach.stl, plate_base.stl, plate_x_left.stl, plate_y.stl]
2014-04-01 dev
    new marling for auto level no servo version
    [Configuration.h, Configuration_adv.h, Menu Plans.xlsx]
2014-04-02 dev update 0.4.6
    cleaned stl files.
    made two plates.
    new : end y . two parts now and ready to accept 200mm wide with 300mm
    smooth rods.
    [Configuration.h, bottom.stl, bottom_center.stl, bottom_y.stl, bottom_z_extruder.stl, bowden_guide.stl, end_x_back.stl, end_x_huxley.stl]
2014-04-05 clean up dev for 4.7 - bug in main marlin
    4.7 ready with plates
    uncomment engage servo in main..was for no servo version
    [Configuration.h, bottom.stl, bowden_guide.stl, end_x_back.stl, end_x_huxley.stl, end_y_back.stl, end_y_back_top.stl, end_y_front.stl]
2014-04-06 marlin little bug
    was a mistake in some values
    [Configuration.h]
2014-04-12 continuation dev.
    release soon. all in prod and shipped.
    [Configuration.h, assembly0.4.7.blend, bars.stl, plate_base.stl, plate_y.stl, shaft_adaptor.stl, smartrap0.4.7_plates.blend]
2014-04-30 0.4.7
    new version.
    - rack and pinion integration
    - new Zcoupler
    - new Zstop attach
    - adjusted things a little everywhere
    [Configuration.h, end_x_back.stl, end_x_huxley.stl, end_y_back.stl, end_y_front.stl, fix_front_48.stl, huxley_attach.stl, pinion5mmshaft.stl]
2014-05-02 update 4.7
    soon to be main!
    - updated rack position ( was too near )
    - updated pinion to simple one with flat shaft. enter in force
    - updated ends huxley endstopz attach.. only one m2.5 now direct in
    pal.. doesn’t move!
    - updated plate_x for new flat cable holder .
    [Configuration.h, end_x_back.stl, end_x_huxley.stl, end_y_back.stl, end_y_front.stl, huxley_attach.stl, pinion5mmshaft.stl, plate_x.stl]
2014-05-02 4.7 update
    moved plates in folder plates
    4.8 = 4.7 + rack integration + last little changes
    - changed endstop x y attach
    [Configuration.h, plate_1.stl, plate_1_48.stl, plate_2.stl, plate_3.stl, plate_4.stl, rack.stl, rack_herringbone.scad]
2014-05-03 more update 0.4.7
    added regpye geared extruder for smartrap.
    [Smartrap_regpye_geared_extruder.stl]
2014-05-04 update 4.7
    longer fix front and back 40
    new bowden guide . debug pb with no servo auto level head
    [Configuration.h, bowden_guide.stl, fix_front_40.stl]
2014-05-04 update 0.4.7. near release
    cleaning plates, cleaning stls
    new glass supports - good for glass 3mm with plumbing joints 15.
    no more stop attach
    [Configuration.h, end_x_huxley.stl, end_y_front.stl, glass_lock_left.stl, glass_lock_right.stl, plate_1.stl, plate_1_48.stl, plate_2.stl]
2014-05-06 update 0.4.7
    some mod ifs a little everywhere after assembly of this version.
    updated plates!
    [4racks.stl, Configuration.h, bowden_guide.stl, end_x_back.stl, end_x_huxley.stl, pinion_roundshaft.stl, plate_1.stl, plate_2.stl]
2014-05-20 production: 0.4.8 mainstream
    NEW :
    - X Y 6mm rods ( will be 8mm too for updates)
    - anti wobble Z
    - rack&pinions X Y
    - 180x180 XY printable : new end Y , need 300mm rods
    V0.4.9 : testing. not good for now !
    [48plate1.stl, 48plate2.stl, 48plate3.stl, 48plate4.stl, LM6UU_Printable_0.5mm_nozzle.stl, LM8UU_0.5_Nozzle_V3.stl, NutM10.stl, NutM4.stl]
2014-05-21 update 04.8
    was the wrong anti wobble support
    new rack 106mm long
    [48plate1.stl, 48plate2.stl, 48plate3.stl, 48plate4.stl, antiwobble_support.stl, endy_front.stl, rack106.stl, rack_herringbone.scad]
2014-05-21 add rack 150mm in 0.4.8
    [rack150mm.stl, rack_herringbone.scad]
2014-05-31 update 048
    updated 048 with:
    - gt2 belt integration complete. still maybe some adjustments
    - new plate_X: smaller , same lm6 holders than other plates
    - fan attach on plate_y for arduino. we don’t use heatsink anymore. was
    for nothing
    [48beltplate1.stl, 48beltplate2.stl, 48beltplate3.stl, 48plate1.stl, 48plate2.stl, 48plate3.stl, Configuration.h, end_x_back.stl]
2014-06-02 update 048
    should have been 049 ! but now it’s done so we stay in 048.
    updated plates for belt system.
    updated ends x y .
    [48beltplate1.stl, 48beltplate2.stl, 48beltplate3.stl, endx_huxley.stl, endy_back.stl, endy_front.stl, mk2_tensioner_left.stl, mk2_tensioner_right.stl]
2014-06-05 update 048 + 048 8mm rods
    new folder with all ready for 048 with 8mm rods
    debug update 048 6mm rods(standard)
    new plates
    [048_plate_8mm.stl, 47plate_1_rs.stl, 47plate_2_rs.stl, 47plate_3_rs.stl, 47plate_4_rs.stl, 48beltplate1.stl, 48beltplate2.stl, 48beltplate3.stl]
2014-06-05 update: new plates 048 8mm rods version
    now 3 plates 140x140.
    was also missing tongue
    [048_8mm_plate_1.stl, 048_8mm_plate_2.stl, 048_8mm_plate_3.stl, smartrap0.4.8_8mm_plates.blend]
2014-06-10 049
    new version:
    - separation extruder
    - debug endY : add a screw to block rods : with gt2 belt, there are new
    forces on the rods and it was turning the ends. now we can block
    - default extruder is still direct drive. integration of geared
    extruder on the work (hidden in blend file).
    - some little changes.. plateX ( remove useless plastic).. etc
    [049plate1.stl, 049plate2.stl, 48beltplate2.stl, Configuration.h, antiwobble_top.stl, assembly0.4.9.blend, bowden_guide.stl, end_X_back.stl]
2014-06-12 update 0.4.9
    new support glass in front with bearing. far more stable
    new support for m4 plate y on base wood. more straight
    new options for extruder direct drive : mk7(10mm) or brass insert (7mm)
    .
    [049plate1.stl, 049plate2.stl, 049plate3.stl, Configuration.h, assembly0.4.9.blend, bearing_gt2_hat.stl, directdrive_body_hux.stl, directdrive_body_m4.stl]
2014-06-19 update 049 - release
    switch release with 049
    updated 049 8mm version
    some changes after assembly ( holes, adjustment)
    [049_8_plate1.stl, 049plate1.stl, 049plate2.stl, 049plate3.stl, Configuration.h, antiwobble_support.stl, attach_bed_left.stl, attach_bed_right.stl]
2014-06-19 update release
    - bug with glass attach right left generation
    - blend files in release : main, assembly, plates
    [049plate1.stl, Configuration.h, attach_bed_right.stl, smartrap0.4.9_plates.blend, smartrap_plate1.stl]
2014-06-30 update production + 8mm rods + new devs
    cleaning folders.
    debug plates 049_8mm
    new debs.. nothing to see for now
    [049_8mm_rp_1.stl, 049_8mm_rp_2.stl, 049_8mm_rp_3.stl, 049_8mm_rp_4.stl, Configuration.h, attach_bed_left.stl, attach_bed_right.stl, bottom_center.stl]
2014-07-02 release update + 8mm version plates update
    [049_8mm_rp_3.stl, 049_8mm_rp_4.stl, endx_huxley.stl, huxley_attach.stl, mk2_tensioner_left.stl, mk2_tensioner_right.stl, smartrap0.4.9_8mm_rp_plates.blend, smartrap0.4.9_plates.blend]
2014-07-07 folder cleaning. export stls.
    [antiwobble_support.stl, antiwobble_top.stl, belt_Y_hat.stl, belt_x_axis.stl, belt_y_axis.stl, bottom.stl, bowden_guide.stl, endx_back.stl]
2014-07-16 small changes.
    Now we update release with small adjustments to make assembly life
    easier.
    - reinforced Z rods on base plate. hole for screw
    - glass lock a little higher
    - huxley attach wider. bend less on fix
    [Configuration.h, MK5_Jhead_Retainer_30mmFan.stl, New_MK5jhead_X_Mount_Arm.stl, New_MK5jhead_X_Mount_ArmPushConnect.stl, New_MK5jhead_X_Mount_Retainer.stl, New_jhead_X_Mount_Arm_Left_V01-1.stl, bed_fix_left.stl, bed_fix_right.stl]
2014-08-20 version 0.4.9.1
    new clamps for lm6uu in case supports are not right
    little changes everywhere to make it more stable and more easy to build
    [Configuration.h, Smartrap.scad, antiwobble_support.stl, antiwobble_top.stl, attach_bed_left.stl, attach_bed_right.stl, bearingsupport_gt2_base_hat.stl, bed_fix_left.stl]
2014-09-02 update release 0.4.9.1 + start 0.4.9.2
    some changes and debug for release. New plates.
    start of 0,4,9,2 with new proxy sensor with jhead lite (huxley to come )
    [Configuration.h, bedsupportextra.stl, bedsupportextra_48.stl, clamp_lm6uu_X_front.stl, endx_jheadlite.stl, endy_front.stl, extruder_directdrive_iddle_10mm.stl, extruder_directdrive_m4.stl]
2014-10-22 version 0.4.9.2
    lot of changes everywhere.
    this push is just to synchronize between local computer to github :
    Very soon now , I will do a big cleaning with versioning , so we will
    have only the release version visible in main branche. I could use tag,
    but i prefer branches for debug.
    [0493-platebase.FCStd, 049_8mm_gt2_1.stl, 049_8mm_gt2_2.stl, Configuration.h, Reprap_Morgan-v1.20.scad, Smartrap 2.scad, base.FCStd, bottom.stl]
2014-10-23 Version 0.4.9.2 CLEAN !
    deep cleaning of the all repository. only last versions are visible
    now. To get old versions, please use the history.
    We will soon open a second branch for development version.
    changes :
    - linear guides holders : back to fixing with screws .
    [048_8mm_plate_1.stl, 048_8mm_plate_2.stl, 048_8mm_plate_3.stl, 048_plate_8mm.stl, 0493-platebase.FCStd, 049_8_plate1.stl, 049_8mm_gt2_1.stl, 049_8mm_gt2_2.stl]
2014-10-26 update endy front separate
    missing hole in endyfront. in separate parts only.
    [endy_front.stl]
2014-10-28 update . debug new extruder
    some cleaning . there was a problem with parts not well oriented
    update direct drive extruder: now double idle to be more strong and an
    extra support from base_plate to prevent bending. results are far
    better !
    [antiwobble_top.stl, directdrive_body_m4.stl, directdrive_body_m4attach.stl, directdrive_extra_support.stl, directdrive_iddle_10mm.stl, directdrive_iddle_10mm_bottom.stl, directdrive_iddle_10mm_top.stl, plateX.stl]
2014-10-28 update-missed a hole
    the extra support for direct drive missed a hole.
    updated assembly .
    [directdrive_extra_support.stl, smartrap_plates_1.stl]
2014-12-02 various updates
    production updates. No big changes now, but a little of everywhere
    changes to make the assembly more easy and right.
    [Configuration.h, bottom.stl, directdrive_iddle_10mm_top.stl, directdrive_iddle_7mm_bottom.stl, directdrive_iddle_7mm_top.stl, endx_jhead.stl, endx_jhead_arm.stl, endx_jhead_attach.stl]
2014-12-14 more small updates in release.
    just small updates . holes for wood screws…etc.
    [Configuration.h, directdrive_body_m4.stl, directdrive_iddle_10mm_bottom.stl, directdrive_iddle_10mm_top.stl, endx_jheadlite_attach.stl, smartrap_8mm_plateX.stl, smartrap_8mm_plates.blend, smartrap_plates_2.stl]
2015-02-06 production update
    remove bottom. eventually it doesn’t do anything important. wood screws
    do the same job without it.
    [Configuration.h, endx_jhead_inductive.stl, endx_jhead_inductive_support.stl, endx_jheadlite_inductivesensor_attach.stl, smartrap_plates_1on2_jhead.stl, smartrap_plates_2on2_jhead.stl]
2015-07-18 changed head adaptor to fit e3d
    [Configuration.h, endx_jhead.stl, endx_jhead_arm.stl, endx_jhead_attach.stl, smartrap_8mm_plates.blend, smartrap_plates_1.stl, smartrap_plates_1_jhead.stl, smartrap_plates_1on2_jhead.stl]
